Aryamanj26/ECE-4180-finalproject/src/main/GesturePreprocessor.hpp

/*
 * Gesture Preprocessor
 * 
 * Handles raw sensor data filtering, noise reduction, and gesture episode detection.
 * Implements a finite state machine to track when a hand enters and leaves the sensor field,
 * recording timing and motion characteristics needed for gesture classification.
 */

#pragma once
#include <Arduino.h>
#include <GestureTypes.hpp>
#include <Logger.hpp>

/*
 * Stores all relevant data about a detected gesture episode
 * Captures timing, distance ranges, and velocity information from all three sensors
 * to enable accurate gesture classification.
 */
struct GestureEpisode
{
    uint32_t tStartMs= 0;
    uint32_t tEndMs= 0;

    uint16_t dMin[3]= { 0xFFFF, 0xFFFF, 0xFFFF };
    uint16_t dMax[3]= { 0, 0, 0 };

    uint8_t  sampleCount= 0;
    uint8_t  winnerChanges= 0;

    // when each sensor first or last saw the object in this episode
    uint32_t firstSeenMs[3]= { 0, 0, 0 };
    uint32_t lastSeenMs[3]= { 0, 0, 0 };

    // peak approach velocity in mm per second toward sensors per sensor
    int16_t  maxApproachVel[3]= { 0, 0, 0 };
};

class GesturePreprocessor
{
public:
    GesturePreprocessor()
    {
        reset();
    }

    /*
     * Processes raw sensor readings and updates the gesture detection state machine
     * Takes distance readings from three sensors, applies filtering and validation,
     * then determines if a gesture episode is starting, ongoing, or complete.
     * Returns EpisodeReady when a gesture has been captured and is ready for classification.
     */
    GestureEvent update(uint16_t d0, uint16_t d1, uint16_t d2, uint32_t nowMs)
    {
        uint16_t raw[3]= { d0, d1, d2 };
        filterDistances(raw);

        // find the closest valid sensor reading in this frame
        uint16_t zMinFrame= 0xFFFF;
        for (int i= 0; i < 3; i++)
        {
            if (inBand(filt[i]) && filt[i] < zMinFrame)
            {
                zMinFrame= filt[i];
            }
        }

        // check which sensors are valid based on being close to the nearest object
        // this prevents background objects from interfering with gesture detection
        bool valid[3]= { false, false, false };
        if (zMinFrame != 0xFFFF)
        {
            uint16_t zMaxAllowed= (uint16_t)(zMinFrame + NEAR_LAYER_TH_MM);
            for (int i= 0; i < 3; i++)
            {
                if (inBand(filt[i]) && filt[i] <= zMaxAllowed)
                {
                    valid[i]= true;
                }
            }
        }

        bool anyValid= valid[0] || valid[1] || valid[2];

        switch (state)
        {
            case State::Idle:
                Logger::ledIdle();
                if (anyValid)
                {
                    // need consecutive valid frames before we start tracking
                    if (++enterCount >= ENTER_COUNT)
                    {
                        LOGGER_DEBUG(Serial.println("[FSM] Idle -> Tracking"));
                        startEpisode(nowMs);
                        appendSample(valid, nowMs);
                        state= State::Tracking;
                        enterCount= 0;
                    }
                }
                else
                {
                    enterCount= 0;
                }
                exitCount= 0;
                break;

            case State::Tracking:
                if (anyValid)
                {
                    exitCount= 0;
                    appendSample(valid, nowMs);

                    // check if episode has gone on too long
                    if (nowMs - ep.tStartMs > MAX_EPISODE_MS)
                    {
                        LOGGER_DEBUG(Serial.println("[FSM] Tracking timeout -> finalizeEpisode()"));
                        if (finalizeEpisode(nowMs))
                        {
                            LOGGER_DEBUG(Serial.println("[FSM] Tracking -> Cooldown (timeout)"));
                            state= State::Cooldown;
                            cooldownUntil= nowMs + COOLDOWN_MS;
                            return GestureEvent::EpisodeReady;
                        }
                        else
                        {
                            LOGGER_DEBUG(Serial.println("[FSM] finalize FAIL -> Idle"));
                            reset();
                        }
                    }
                }
                else
                {
                    // hand left sensor field so finish the episode
                    if (++exitCount >= EXIT_COUNT)
                    {
                        LOGGER_DEBUG(Serial.println("[FSM] Tracking exitCount reached -> finalizeEpisode()"));
                        if (finalizeEpisode(nowMs))
                        {
                            LOGGER_DEBUG(Serial.println("[FSM] Tracking -> Cooldown (hand left)"));
                            state= State::Cooldown;
                            cooldownUntil= nowMs + COOLDOWN_MS;
                            return GestureEvent::EpisodeReady;
                        }
                        else
                        {
                            LOGGER_DEBUG(Serial.println("[FSM] finalize FAIL -> Idle"));
                            reset();
                        }
                    }
                }
                break;

            case State::Cooldown:
                if (!anyValid && nowMs >= cooldownUntil)
                {
                    LOGGER_DEBUG(Serial.println("[FSM] Cooldown -> Idle"));
                    reset();
                }
                break;
        }

        return GestureEvent::None;
    }


    /*
     * Returns the most recently completed gesture episode
     * Used after receiving EpisodeReady event to get the data for classification.
     */
    const GestureEpisode &lastEpisode() const
    {
        return ep;
    }

private:
    enum class State
    {
        Idle,
        Tracking,
        Cooldown
    };

    // distance band for your 8 to 14 cm gesture plane
    static constexpr uint16_t D_MIN_MM= 30;
    static constexpr uint16_t D_MAX_MM= 140;

    // loosen start and stop so episodes actually happen
    static constexpr uint8_t  ENTER_COUNT= 1;
    static constexpr uint8_t  EXIT_COUNT= 2;

    // looser episode duration
    static constexpr uint32_t MIN_EPISODE_MS= 20;
    static constexpr uint32_t MAX_EPISODE_MS= 2000;

    // looser radial movement requirement we can tighten later
    static constexpr uint16_t MIN_SWING_MM= 5;

    // nearest layer gating how far behind the nearest object we still accept
    static constexpr uint16_t NEAR_LAYER_TH_MM= 20;

    static constexpr uint32_t COOLDOWN_MS= 5;

    // how many consecutive invalid frames before we clear filt for that sensor
    static constexpr uint8_t  INVALID_RESET_COUNT= 50;

    State    state;
    uint8_t  enterCount;
    uint8_t  exitCount;
    uint32_t cooldownUntil;

    uint16_t rawHist[3][3];
    uint8_t  rawIdx;
    uint16_t filt[3];
    uint8_t  invalidCount[3];

    // for velocity estimation
    uint16_t lastFiltForVel[3]= { 0, 0, 0 };
    uint32_t lastTimeForVel[3]= { 0, 0, 0 };

    GestureEpisode ep;
    int8_t  lastWinner;

    void reset()
    {
        state= State::Idle;
        enterCount= exitCount= 0;
        cooldownUntil= 0;
        rawIdx= 0;
        lastWinner= -1;

        for (int i= 0; i < 3; i++)
        {
            filt[i]= 0;
            invalidCount[i]= 0;
            lastFiltForVel[i]= 0;
            lastTimeForVel[i]= 0;
            for (int j= 0; j < 3; j++)
            {
                rawHist[i][j]= 0;
            }
            ep.dMin[i]= 0xFFFF;
            ep.dMax[i]= 0;
            ep.firstSeenMs[i]= 0;
            ep.lastSeenMs[i]= 0;
            ep.maxApproachVel[i]= 0;
        }
        ep.sampleCount= 0;
        ep.winnerChanges= 0;
        ep.tStartMs= ep.tEndMs= 0;
    }

    static bool inBand(uint16_t d)
    {
        return d >= D_MIN_MM && d <= D_MAX_MM;
    }

    static uint16_t median3(uint16_t a, uint16_t b, uint16_t c)
    {
        if (a > b)
        {
            uint16_t t= a;
            a= b;
            b= t;
        }
        if (b > c)
        {
            uint16_t t= b;
            b= c;
            c= t;
        }
        if (a > b)
        {
            uint16_t t= a;
            a= b;
            b= t;
        }
        return b;
    }

    /*
     * Filters and validates raw sensor distance readings
     * Uses a circular buffer and median filtering to handle invalid readings,
     * then applies nearest-layer gating and exponential moving average to reduce noise.
     * This ensures only valid, foreground objects are tracked for gesture detection.
     */
    void filterDistances(const uint16_t raw[3])
    {
        rawIdx= (rawIdx + 1) % 3;

        uint16_t m[3];

        // first compute m for each sensor with preference for current valid raw
        for (int i= 0; i < 3; i++)
        {
            rawHist[i][rawIdx]= raw[i];

            // valid reading
            if (raw[i] != 0 && raw[i] != 0xFFFF)
            {
                m[i]= raw[i];
            }
            else
            {
                // invalid reading use median of history
                m[i]= median3(rawHist[i][0], rawHist[i][1], rawHist[i][2]);
            }
        }

        // find the closest valid reading aka closest object to the sensors
        // this way the sensors are not influenced by the background or noise when making a gesture
        uint16_t zMinFrame= 0xFFFF;
        for (int i= 0; i < 3; i++)
        {
            if (m[i]== 0 || m[i]== 0xFFFF)
            {
                continue;
            }
            if (m[i] < zMinFrame)
            {
                zMinFrame= m[i];
            }
        }

        // if no valid medians at all treat everything as invalid and decay filters and reset
        if (zMinFrame== 0xFFFF)
        {
            for (int i= 0; i < 3; i++)
            {
                if (invalidCount[i] < 255)
                {
                    invalidCount[i]++;
                }
                if (invalidCount[i] >= INVALID_RESET_COUNT)
                {
                    filt[i]= 0;
                }
            }
            return;
        }

        // for each sensor only keep values in the global band determined above
        // and within its area determined by near layer threshold
        // ignore everything else beyond the closest sensed threshold
        uint16_t zMaxAllowed= (uint16_t)(zMinFrame + NEAR_LAYER_TH_MM);

        for (int i= 0; i < 3; i++)
        {
            uint16_t mi= m[i];
            bool thisValid= (mi != 0 && mi != 0xFFFF) &&
                             (mi >= D_MIN_MM && mi <= D_MAX_MM) &&
                             (mi <= zMaxAllowed);

            if (!thisValid)
            {
                if (invalidCount[i] < 255)
                {
                    invalidCount[i]++;
                }
                if (invalidCount[i] >= INVALID_RESET_COUNT)
                {
                    filt[i]= 0;
                }
                continue;
            }

            invalidCount[i]= 0;
            if (filt[i]== 0)
            {
                filt[i]= mi;
            }
            else
            {
                // exponential moving average to smooth out noise
                filt[i]= (uint16_t)((3u * filt[i] + mi) / 4u);
            }
        }
    }

    /*
     * Initializes a new gesture episode when hand enters sensor field
     * Resets all tracking variables to prepare for recording the new gesture.
     */
    void startEpisode(uint32_t nowMs)
    {
        ep.tStartMs= nowMs;
        ep.sampleCount= 0;
        ep.winnerChanges= 0;
        for (int i= 0; i < 3; i++)
        {
            ep.dMin[i]= 0xFFFF;
            ep.dMax[i]= 0;
            ep.firstSeenMs[i]= 0;
            ep.lastSeenMs[i]= 0;
            ep.maxApproachVel[i]= 0;
        }
        lastWinner= -1;
    }

    /*
     * Adds a new sensor reading sample to the current gesture episode
     * Records timing, velocity, and distance information for each active sensor
     * to build up a complete picture of the hand movement.
     */
    void appendSample(const bool valid[3], uint32_t nowMs)
    {
        ep.sampleCount++;

        uint16_t best= 0xFFFF;
        int8_t winner= -1;

        for (int i= 0; i < 3; i++)
        {
            uint16_t d= filt[i];

            if (valid[i])
            {
                // mark first and last seen times for this sensor in this episode
                if (ep.firstSeenMs[i]== 0)
                {
                    ep.firstSeenMs[i]= nowMs;
                }
                ep.lastSeenMs[i]= nowMs;

                // compute per sample approach velocity if we have a previous sample
                // velocity is positive when hand moves closer to sensors
                if (lastFiltForVel[i] != 0 && d != 0 && lastTimeForVel[i] != 0)
                {
                    uint32_t dt= nowMs - lastTimeForVel[i];
                    if (dt > 0)
                    {
                        // distance change greater than zero means moving closer
                        int16_t dv= (int16_t)lastFiltForVel[i] - (int16_t)d;
                        if (dv > 0)
                        {
                            // convert to mm per second
                            int16_t v= (int16_t)((dv * 1000) / (int32_t)dt);
                            if (v > ep.maxApproachVel[i])
                            {
                                ep.maxApproachVel[i]= v;
                            }
                        }
                    }
                }

                // update radial swing stats
                if (d < ep.dMin[i])
                {
                    ep.dMin[i]= d;
                }
                if (d > ep.dMax[i])
                {
                    ep.dMax[i]= d;
                }

                if (d < best)
                {
                    best= d;
                    winner= i;
                }
            }

            // update velocity history for next time
            lastFiltForVel[i]= d;
            lastTimeForVel[i]= nowMs;
        }

        // track which sensor sees the closest object and count changes
        if (winner >= 0)
        {
            if (lastWinner >= 0 && winner != lastWinner)
            {
                ep.winnerChanges++;
            }
            lastWinner= winner;
        }
    }

    /*
     * Validates and completes a gesture episode
     * Checks if the recorded data meets minimum requirements for a valid gesture
     * (sufficient duration, movement magnitude, or velocity).
     */
    bool finalizeEpisode(uint32_t nowMs)
    {
        ep.tEndMs= nowMs;

        LOGGER_DEBUG(Serial.println("---- finalizeEpisode ----"));

        if (ep.sampleCount < 2)
        {
            Logger::log(Logger::Level::Warn, "Episode finalize failed: sampleCount < 2");
            LOGGER_DEBUG(Serial.println("FAIL: sampleCount < 2"));
            return false;
        }

        uint32_t dur= ep.tEndMs - ep.tStartMs;
        if (dur < MIN_EPISODE_MS)
        {
            Logger::log(Logger::Level::Warn, "Episode finalize failed: duration too short");
            LOGGER_DEBUG(Serial.println("FAIL: duration too short"));
            return false;
        }

        // find the maximum swing from any sensor
        // swing is how much the distance changed during the gesture
        uint16_t maxSwing= 0;
        for (int i= 0; i < 3; i++)
        {
            if (ep.dMin[i] != 0xFFFF)
            {
                uint16_t swing= ep.dMax[i] - ep.dMin[i];
                if (swing > maxSwing)
                {
                    maxSwing= swing;
                }
            }
        }

        int16_t maxV= ep.maxApproachVel[0];
        if (ep.maxApproachVel[1] > maxV)
        {
            maxV= ep.maxApproachVel[1];
        }
        if (ep.maxApproachVel[2] > maxV)
        {
            maxV= ep.maxApproachVel[2];
        }

        // gesture needs either decent swing or decent velocity to be valid
        if (maxSwing < MIN_SWING_MM && maxV < 200)
        {
            Logger::log(Logger::Level::Warn, "Episode finalize failed: weak swing + weak velocity");
            LOGGER_DEBUG(Serial.println("FAIL: weak swing + weak velocity"));
            return false;
        }

        LOGGER_DEBUG(Serial.println("PASS: Episode finalized!"));
        return true;
    }


};
