Aryamanj26/ECE-4180-finalproject/(commit log)

2025-11-19 added button toggle
2025-11-20 circuit diagram added.
2025-12-04 added circuit diagram to project report
